soggybag/CVSpeak/hardware/README.md

# CVSpeak hardware

The Eurorack module: 14 HP, one PCB plus a front panel, with a Raspberry Pi Pico 2 and an ES8388 codec. The firmware lives in `../firmware/`, and the DSP core it shares with the VCV plugin lives in `../dsp/`.

## Docs

- [Hardware decisions](docs/Hardware%20Decisions.md): what was decided and why, the circuit blocks, open items, and what to bench on the Palimpsest boards first.
- [Pin map](docs/Pin%20map.md): Pico 2 GPIO, mux channels, and the signal conventions for the firmware.
- Panel layout: `../tools/make_panel.py` (`make panel`). It is the single source of the hole and part positions, shared with the VCV panel.

## Status

2026-11-07: decisions, pin map and **schematic v0.0** (draft, not yet benched). `make schematic` regenerates `CVSpeak.kicad_sch` from `scripts/build_sch.py` and runs ERC.

## Files

| File | What |
|---|---|
| `CVSpeak.kicad_sch` | Generated: edit `scripts/build_sch.py`, not the sheet |
| `CVSpeak.kicad_sym` | Generated by `scripts/make_symbols.py`: the SH1106 OLED and the Pico 2 |
| `CVSpeak.pretty/` | Project footprints (button; OLED still to draw) |
| `scripts/sch.py`, `sx.py`, `lib.py` | Schematic helpers, copied from Palimpsest |
