soggybag/CVSpeak/hardware/CVSpeak.kicad_sch

## KiCad design hardware/CVSpeak.kicad_sch (2026-11-08)

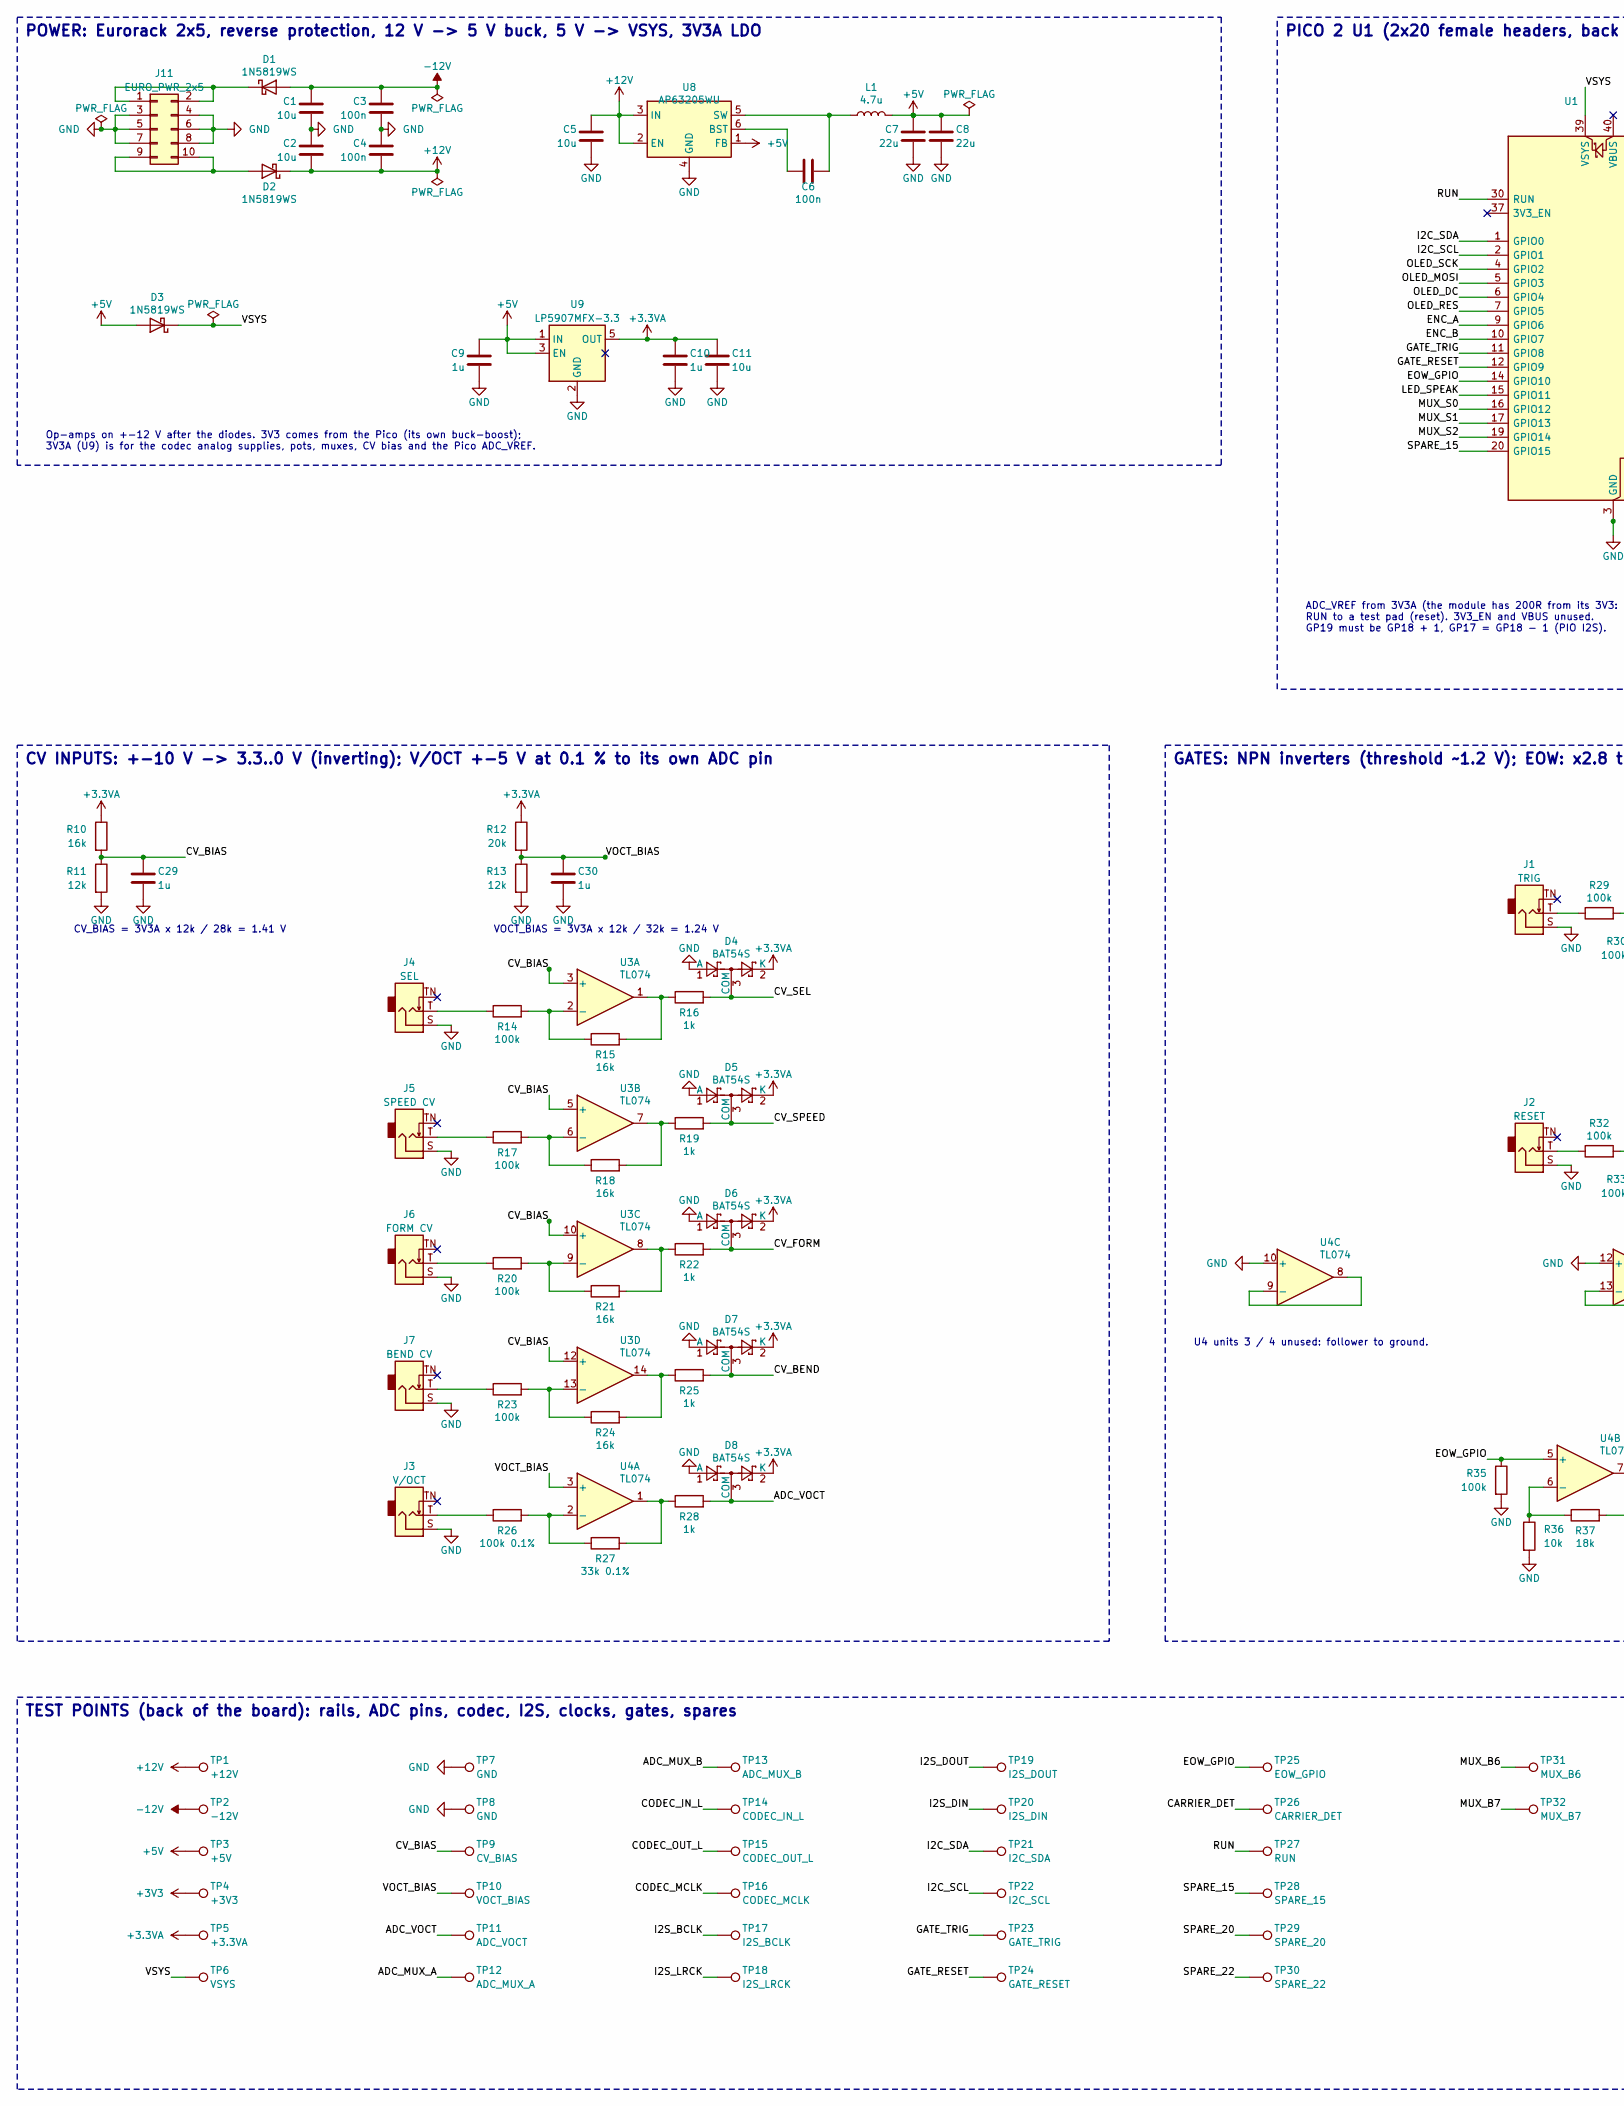
[picture p1: schematic CVSpeak.kicad_sch, part in row 1, column 1]

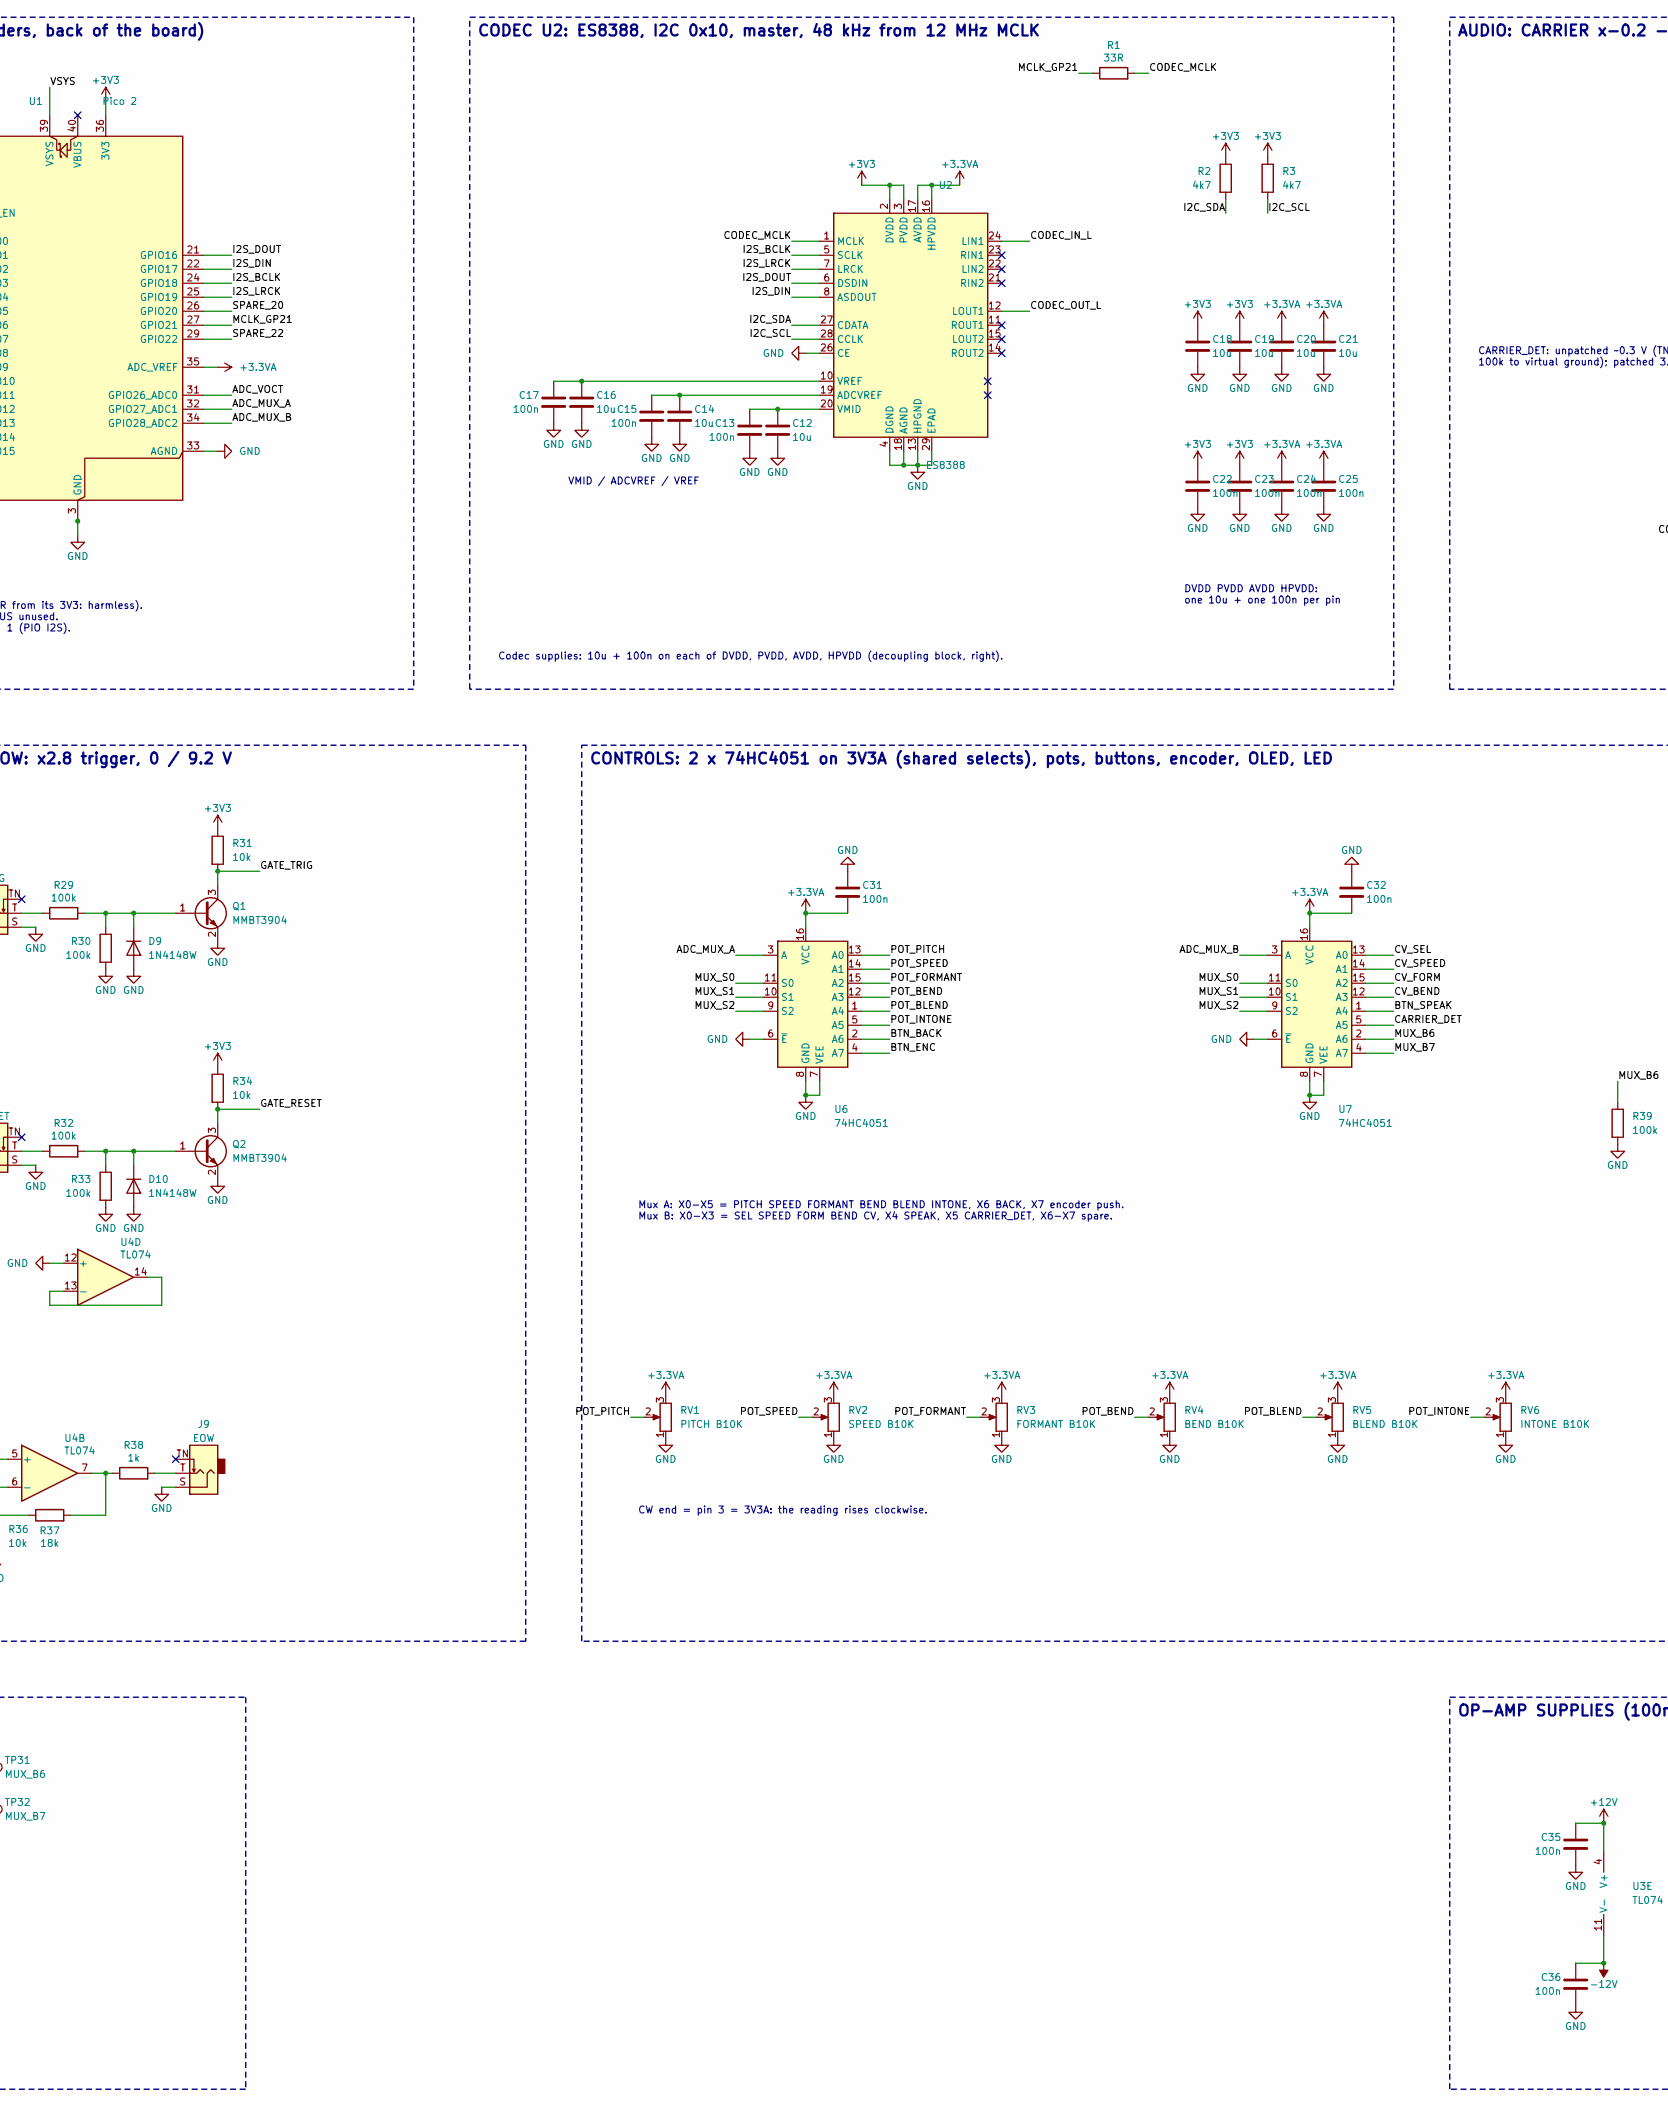
[picture p2: schematic CVSpeak.kicad_sch, part in row 1, column 2]

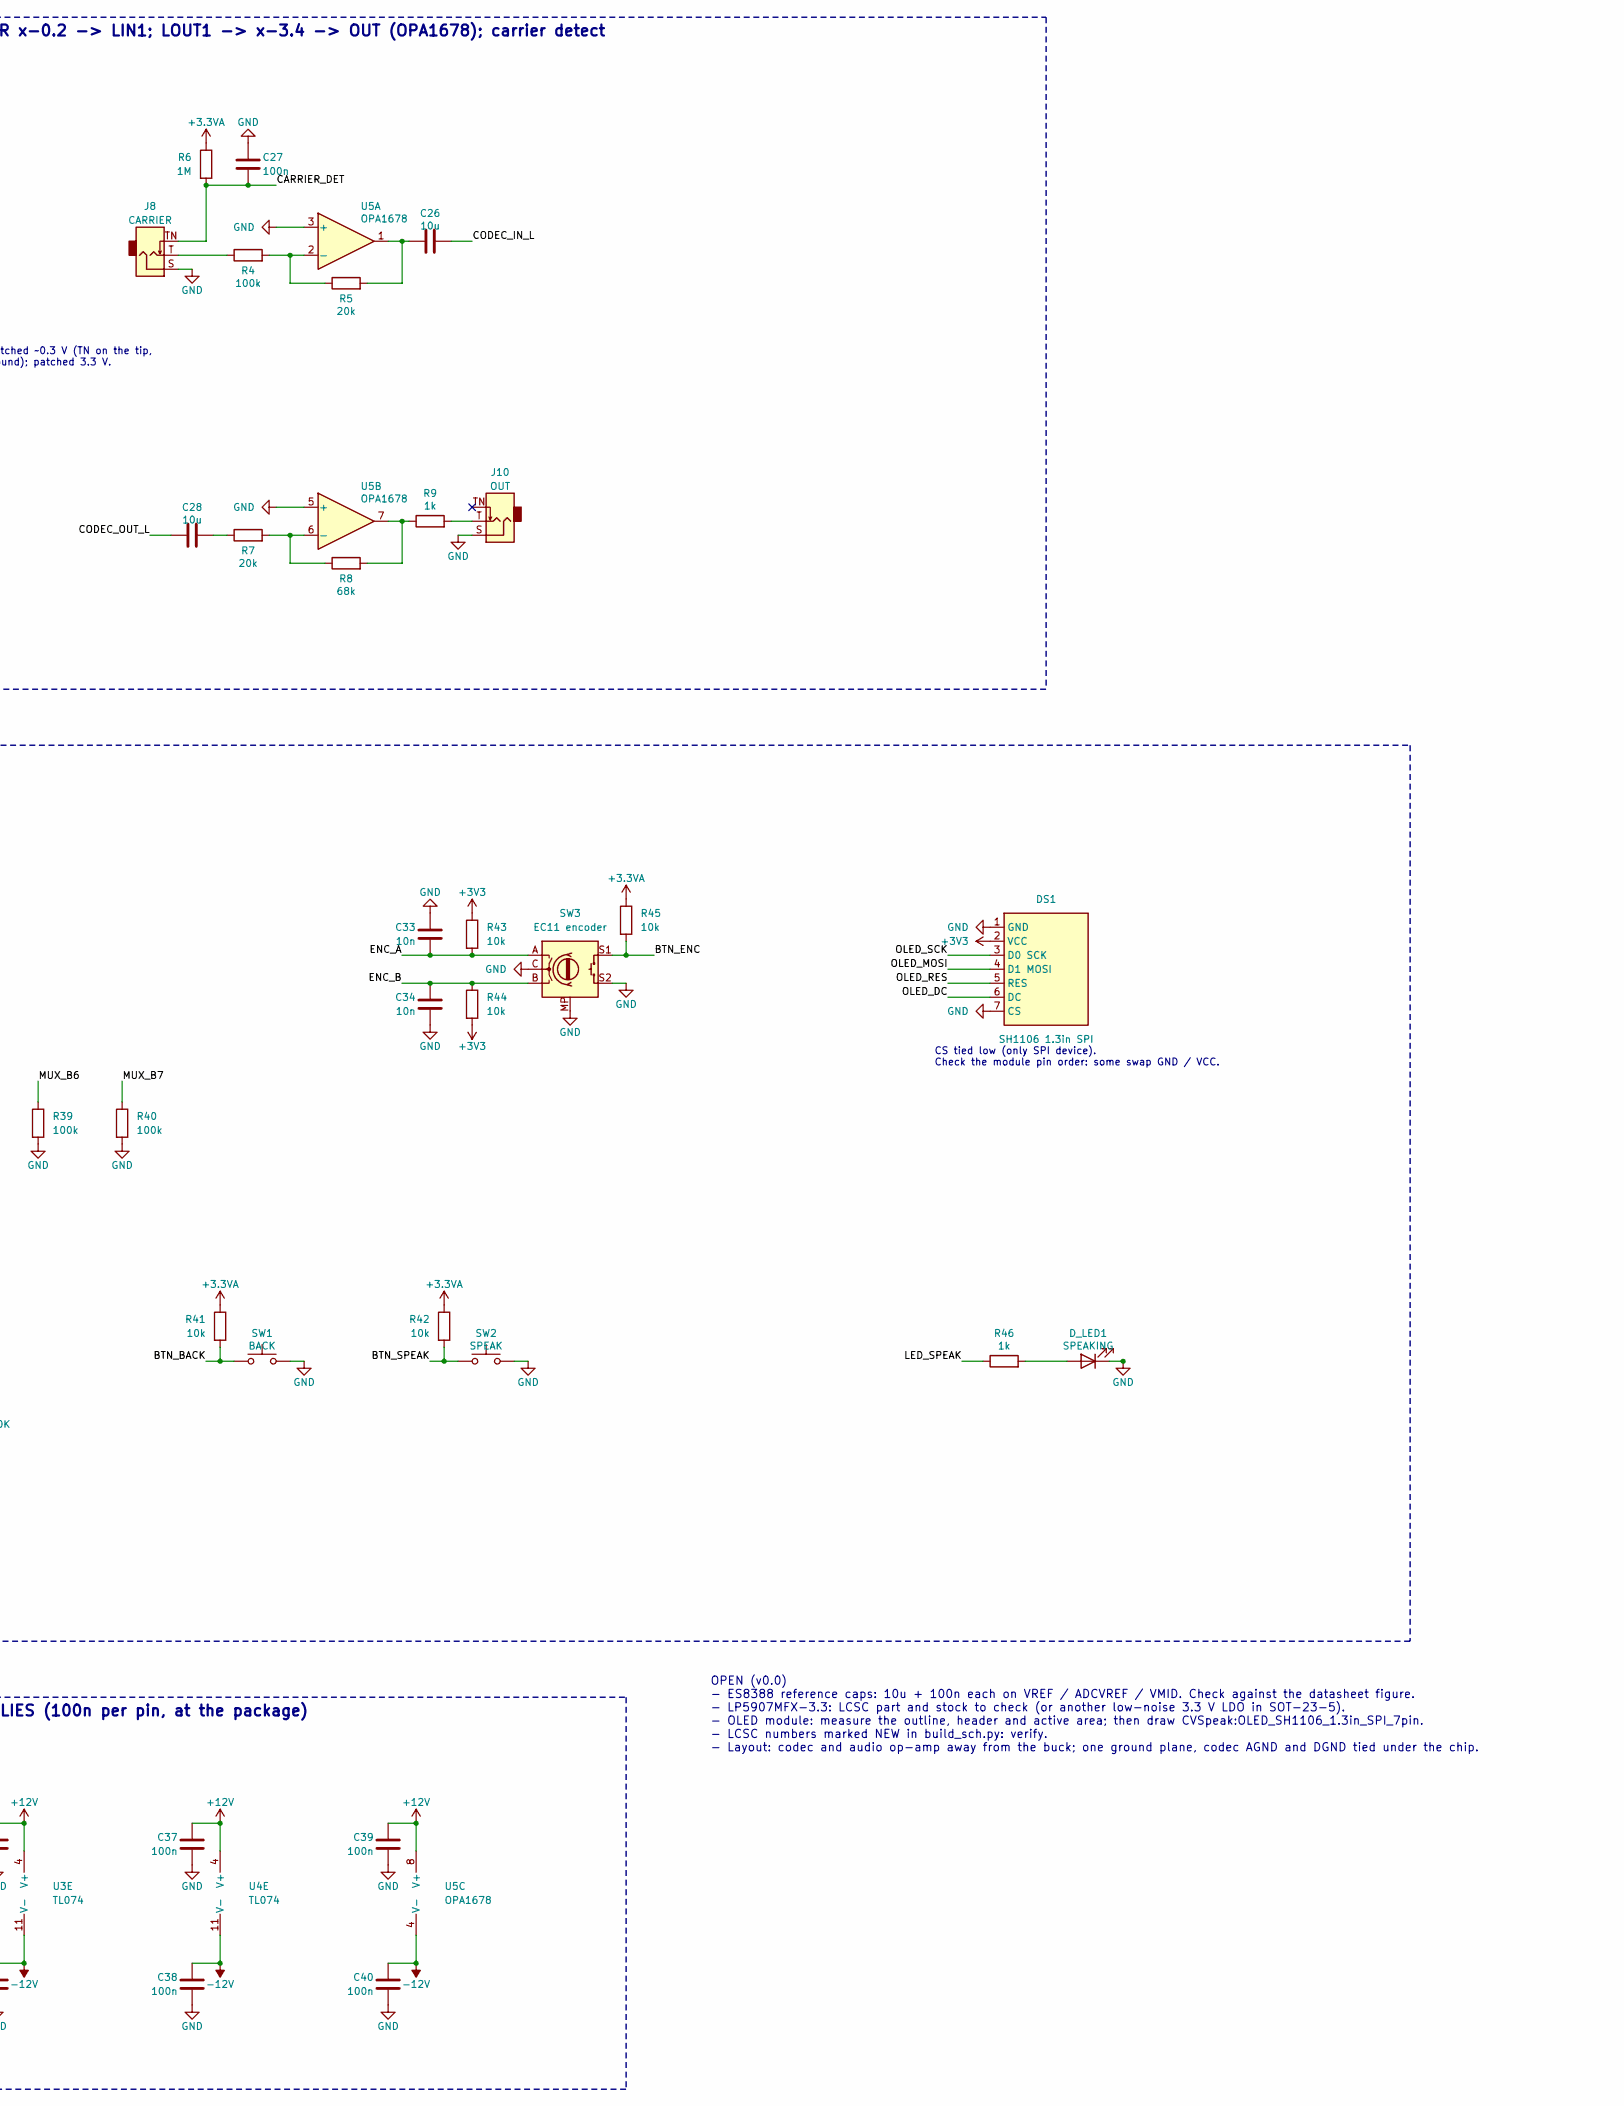
[picture p3: schematic CVSpeak.kicad_sch, part in row 1, column 3]

Parts:
C1, C2, C5, C11, C12, C14, C16, C18, C19, C20, C21, C26, C28: 10u; C_0805_2012Metric_Pad1.18x1.45mm_HandSolder; LCSC C15850
C3, C4, C6, C13, C15, C17, C22, C23, C24, C25, C27, C31, C32, C35, C36, C37, C38, C39, C40: 100n; C_0805_2012Metric_Pad1.18x1.45mm_HandSolder; LCSC C49678
C7, C8: 22u; C_0805_2012Metric_Pad1.18x1.45mm_HandSolder; LCSC C45783
C9, C10, C29, C30: 1u; C_0805_2012Metric_Pad1.18x1.45mm_HandSolder; LCSC C28323
C33, C34: 10n; C_0805_2012Metric_Pad1.18x1.45mm_HandSolder; LCSC C1710
D1, D2, D3: 1N5819WS; D_SOD-323; LCSC C191023
D4, D5, D6, D7, D8: BAT54S; SOT-23; LCSC C19726
D9, D10: 1N4148W; D_SOD-123; LCSC C81598
DS1: SH1106 1.3in SPI; OLED_SH1106_1.3in_SPI_7pin
D_LED1: SPEAKING; LED_D3.0mm
J1: TRIG; Jack_3.5mm_QingPu_WQP-PJ398SM_Vertical_CircularHoles
J2: RESET; Jack_3.5mm_QingPu_WQP-PJ398SM_Vertical_CircularHoles
J3: V/OCT; Jack_3.5mm_QingPu_WQP-PJ398SM_Vertical_CircularHoles
J4: SEL; Jack_3.5mm_QingPu_WQP-PJ398SM_Vertical_CircularHoles
J5: SPEED CV; Jack_3.5mm_QingPu_WQP-PJ398SM_Vertical_CircularHoles
J6: FORM CV; Jack_3.5mm_QingPu_WQP-PJ398SM_Vertical_CircularHoles
J7: BEND CV; Jack_3.5mm_QingPu_WQP-PJ398SM_Vertical_CircularHoles
J8: CARRIER; Jack_3.5mm_QingPu_WQP-PJ398SM_Vertical_CircularHoles
J9: EOW; Jack_3.5mm_QingPu_WQP-PJ398SM_Vertical_CircularHoles
J10: OUT; Jack_3.5mm_QingPu_WQP-PJ398SM_Vertical_CircularHoles
J11: EURO_PWR_2x5; IDC-Header_2x05_P2.54mm_Vertical
L1: 4.7u; L_Bourns-SRN4018; LCSC C780206
Q1, Q2: MMBT3904; SOT-23; LCSC C20526
R1: 33R; R_0805_2012Metric_Pad1.20x1.40mm_HandSolder; LCSC C17634
R2, R3: 4k7; R_0805_2012Metric_Pad1.20x1.40mm_HandSolder; LCSC C17673
R4, R14, R17, R20, R23, R29, R30, R32, R33, R35, R39, R40: 100k; R_0805_2012Metric_Pad1.20x1.40mm_HandSolder; LCSC C149504
R5, R7, R12: 20k; R_0805_2012Metric_Pad1.20x1.40mm_HandSolder; LCSC C4328
R6: 1M; R_0805_2012Metric_Pad1.20x1.40mm_HandSolder; LCSC C17514
R8: 68k; R_0805_2012Metric_Pad1.20x1.40mm_HandSolder; LCSC C17801
R9, R16, R19, R22, R25, R28, R38, R46: 1k; R_0805_2012Metric_Pad1.20x1.40mm_HandSolder; LCSC C17513
R10, R15, R18, R21, R24: 16k; R_0805_2012Metric_Pad1.20x1.40mm_HandSolder; LCSC C17490
R11, R13: 12k; R_0805_2012Metric_Pad1.20x1.40mm_HandSolder; LCSC C17444
R26: 100k 0.1%; R_0805_2012Metric_Pad1.20x1.40mm_HandSolder; LCSC C122537
R27: 33k 0.1%; R_0805_2012Metric_Pad1.20x1.40mm_HandSolder; LCSC C2849182
R31, R34, R36, R41, R42, R43, R44, R45: 10k; R_0805_2012Metric_Pad1.20x1.40mm_HandSolder; LCSC C17414
R37: 18k; R_0805_2012Metric_Pad1.20x1.40mm_HandSolder; LCSC C17506
RV1: PITCH B10K; Potentiometer_Alpha_RD901F-40-00D_Single_Vertical
RV2: SPEED B10K; Potentiometer_Alpha_RD901F-40-00D_Single_Vertical
RV3: FORMANT B10K; Potentiometer_Alpha_RD901F-40-00D_Single_Vertical
RV4: BEND B10K; Potentiometer_Alpha_RD901F-40-00D_Single_Vertical
RV5: BLEND B10K; Potentiometer_Alpha_RD901F-40-00D_Single_Vertical
RV6: INTONE B10K; Potentiometer_Alpha_RD901F-40-00D_Single_Vertical
SW1: BACK; SW_Push_Round_D12mm_P5.00mm_DAIER_TSL-A064
SW2: SPEAK; SW_Push_Round_D12mm_P5.00mm_DAIER_TSL-A064
SW3: EC11 encoder; RotaryEncoder_Alps_EC11E-Switch_Vertical_H20mm
TP1: +12V; TestPoint_Pad_D1.5mm
TP2: -12V; TestPoint_Pad_D1.5mm
TP3: +5V; TestPoint_Pad_D1.5mm
TP4: +3V3; TestPoint_Pad_D1.5mm
TP5: +3.3VA; TestPoint_Pad_D1.5mm
TP6: VSYS; TestPoint_Pad_D1.5mm
TP7, TP8: GND; TestPoint_THTPad_D2.0mm_Drill1.0mm
TP9: CV_BIAS; TestPoint_Pad_D1.5mm
TP10: VOCT_BIAS; TestPoint_Pad_D1.5mm
TP11: ADC_VOCT; TestPoint_Pad_D1.5mm
TP12: ADC_MUX_A; TestPoint_Pad_D1.5mm
TP13: ADC_MUX_B; TestPoint_Pad_D1.5mm
TP14: CODEC_IN_L; TestPoint_Pad_D1.5mm
TP15: CODEC_OUT_L; TestPoint_Pad_D1.5mm
TP16: CODEC_MCLK; TestPoint_Pad_D1.5mm
TP17: I2S_BCLK; TestPoint_Pad_D1.5mm
TP18: I2S_LRCK; TestPoint_Pad_D1.5mm
TP19: I2S_DOUT; TestPoint_Pad_D1.5mm
TP20: I2S_DIN; TestPoint_Pad_D1.5mm
TP21: I2C_SDA; TestPoint_Pad_D1.5mm
TP22: I2C_SCL; TestPoint_Pad_D1.5mm
TP23: GATE_TRIG; TestPoint_Pad_D1.5mm
TP24: GATE_RESET; TestPoint_Pad_D1.5mm
TP25: EOW_GPIO; TestPoint_Pad_D1.5mm
TP26: CARRIER_DET; TestPoint_Pad_D1.5mm
TP27: RUN; TestPoint_Pad_D1.5mm
TP28: SPARE_15; TestPoint_Pad_D1.5mm
TP29: SPARE_20; TestPoint_Pad_D1.5mm
TP30: SPARE_22; TestPoint_Pad_D1.5mm
TP31: MUX_B6; TestPoint_Pad_D1.5mm
TP32: MUX_B7; TestPoint_Pad_D1.5mm
U1: Pico 2; RaspberryPi_Pico_Common_THT
U2: ES8388; QFN-28-1EP_4x4mm_P0.45mm_EP2.6x2.6mm; LCSC C365736
U3, U4: TL074; SOIC-14_3.9x8.7mm_P1.27mm; LCSC C6963
U5: OPA1678; SOIC-8_3.9x4.9mm_P1.27mm; LCSC C192421
U6, U7: 74HC4051; SOIC-16_3.9x9.9mm_P1.27mm; LCSC C132065
U8: AP63205WU; TSOT-23-6; LCSC C2071056
U9: LP5907MFX-3.3; SOT-23-5

Connections:
+3.3VA: C10.1, C11.1, C20.1, C21.1, C24.1, C25.1, C31.2, C32.2, D4.2 (K), D5.2 (K), D6.2 (K), D7.2 (K), D8.2 (K), R6.1, R10.1, R12.1, R41.1, R42.1, R45.1, RV1.3, RV2.3, RV3.3, RV4.3, RV5.3, RV6.3, TP5.1, U1.35 (ADC_VREF), U2.16 (HPVDD), U2.17 (AVDD), U6.16 (VCC), U7.16 (VCC), U9.5 (OUT)
+3V3: C18.1, C19.1, C22.1, C23.1, DS1.2 (VCC), R2.1, R3.1, R31.1, R34.1, R43.1, R44.2, TP4.1, U1.36 (3V3), U2.2 (DVDD), U2.3 (PVDD)
+12V: C1.1, C1.2, C2.1, C2.2, C3.1, C3.2, C4.1, C4.2, C5.1, C5.2, C7.1, C7.2, C8.1, C8.2, C9.1, C9.2, C10.2, C11.2, C12.2, C13.2, C14.2, C15.2, C16.2, C17.2, C18.2, C19.2, C20.2, C21.2, C22.2, C23.2, C24.2, C25.2, C27.1, C29.2, C30.2, C31.1, C32.1, C33.1, C34.2, C35.1, C35.2, C36.1, C36.2, C37.1, C37.2, C38.1, C38.2, C39.1, C39.2, C40.1, C40.2, D1.2 (A), D2.1 (K), D3.1 (K), D3.2 (A), D4.1 (A), D5.1 (A), D6.1 (A), D7.1 (A), D8.1 (A), D9.2 (A), D10.2 (A), DS1.1 (GND), DS1.7 (CS), D_LED1.1 (K), J1.S, J2.S, J3.S, J4.S, J5.S, J6.S, J7.S, J8.S, J9.S, J10.S, J11.3, J11.4, J11.5, J11.6, J11.7, J11.8, L1.2, Q1.2 (E), Q2.2 (E), R11.2, R13.2, R30.2, R33.2, R35.2, R36.2, R39.2, R40.2, RV1.1, RV2.1, RV3.1, RV4.1, RV5.1, RV6.1, SW1.2, SW2.2, SW3.C, SW3.MP, SW3.S2, TP1.1, TP2.1, TP3.1, TP6.1, TP7.1, TP8.1, U1.3 (GND), U1.8 (GND), U1.13 (GND), U1.18 (GND), U1.23 (GND), U1.28 (GND), U1.33 (AGND), U1.38 (GND), U1.39 (VSYS), U2.4 (DGND), U2.13 (HPGND), U2.18 (AGND), U2.26 (CE), U2.29 (EPAD), U3.4 (V+), U3.11 (V-), U4.4 (V+), U4.10 (+), U4.11 (V-), U4.12 (+), U5.3 (+), U5.4 (V-), U5.5 (+), U5.8 (V+), U6.6 (~E), U6.7 (VEE), U6.8 (GND), U7.6 (~E), U7.7 (VEE), U7.8 (GND), U8.1 (FB), U8.2 (EN), U8.3 (IN), U8.4 (GND), U9.1 (IN), U9.2 (GND), U9.3 (EN)
ADC_MUX_A: TP12.1, U1.32 (GPIO27_ADC1), U6.3 (A)
ADC_MUX_B: TP13.1, U1.34 (GPIO28_ADC2), U7.3 (A)
ADC_VOCT: D8.3 (COM), R28.2, TP11.1, U1.31 (GPIO26_ADC0)
BTN_BACK: R41.2, SW1.1, U6.2 (A6)
BTN_ENC: R45.2, SW3.S1, U6.4 (A7)
BTN_SPEAK: R42.2, SW2.1, U7.1 (A4)
CARRIER_DET: C27.2, J8.TN, R6.2, TP26.1, U7.5 (A5)
CODEC_IN_L: C26.2, TP14.1, U2.24 (LIN1)
CODEC_MCLK: R1.2, TP16.1, U2.1 (MCLK)
CODEC_OUT_L: C28.1, TP15.1, U2.12 (LOUT1)
CV_BEND: D7.3 (COM), R25.2, U7.12 (A3)
CV_BIAS: C29.1, R10.2, R11.1, TP9.1, U3.3 (+), U3.5 (+), U3.10 (+), U3.12 (+)
CV_FORM: D6.3 (COM), R22.2, U7.15 (A2)
CV_SEL: D4.3 (COM), R16.2, U7.13 (A0)
CV_SPEED: D5.3 (COM), R19.2, U7.14 (A1)
ENC_A: C33.2, R43.2, SW3.A, U1.9 (GPIO6)
ENC_B: C34.1, R44.1, SW3.B, U1.10 (GPIO7)
EOW_GPIO: R35.1, TP25.1, U1.14 (GPIO10), U4.5 (+)
GATE_RESET: Q2.3 (C), R34.2, TP24.1, U1.12 (GPIO9)
GATE_TRIG: Q1.3 (C), R31.2, TP23.1, U1.11 (GPIO8)
I2C_SCL: R3.2, TP22.1, U1.2 (GPIO1), U2.28 (CCLK)
I2C_SDA: R2.2, TP21.1, U1.1 (GPIO0), U2.27 (CDATA)
I2S_BCLK: TP17.1, U1.24 (GPIO18), U2.5 (SCLK)
I2S_DIN: TP20.1, U1.22 (GPIO17), U2.8 (ASDOUT)
I2S_DOUT: TP19.1, U1.21 (GPIO16), U2.6 (DSDIN)
I2S_LRCK: TP18.1, U1.25 (GPIO19), U2.7 (LRCK)
LED_SPEAK: R46.1, U1.15 (GPIO11)
MCLK_GP21: R1.1, U1.27 (GPIO21)
MUX_B6: R39.1, TP31.1, U7.2 (A6)
MUX_B7: R40.1, TP32.1, U7.4 (A7)
MUX_S0: U1.16 (GPIO12), U6.11 (S0), U7.11 (S0)
MUX_S1: U1.17 (GPIO13), U6.10 (S1), U7.10 (S1)
MUX_S2: U1.19 (GPIO14), U6.9 (S2), U7.9 (S2)
unnamed: C6.1, U8.6 (BST)
unnamed: C6.2, L1.1, U8.5 (SW)
unnamed: C12.1, C13.1, U2.20 (VMID)
unnamed: C14.1, C15.1, U2.19 (ADCVREF)
unnamed: C16.1, C17.1, U2.10 (VREF)
unnamed: C26.1, R5.2, U5.1
unnamed: C28.2, R7.1
unnamed: D1.1 (K), J11.1, J11.2
unnamed: D2.2 (A), J11.9, J11.10
unnamed: D9.1 (K), Q1.1 (B), R29.2, R30.1
unnamed: D10.1 (K), Q2.1 (B), R32.2, R33.1
unnamed: D_LED1.2 (A), R46.2
unnamed: J1.T, R29.1
unnamed: J2.T, R32.1
unnamed: J3.T, R26.1
unnamed: J4.T, R14.1
unnamed: J5.T, R17.1
unnamed: J6.T, R20.1
unnamed: J7.T, R23.1
unnamed: J8.T, R4.1
unnamed: J9.T, R38.2
unnamed: J10.T, R9.2
unnamed: R4.2, R5.1, U5.2 (-)
unnamed: R7.2, R8.1, U5.6 (-)
unnamed: R8.2, R9.1, U5.7
unnamed: R14.2, R15.1, U3.2 (-)
unnamed: R15.2, R16.1, U3.1
unnamed: R17.2, R18.1, U3.6 (-)
unnamed: R18.2, R19.1, U3.7
unnamed: R20.2, R21.1, U3.9 (-)
unnamed: R21.2, R22.1, U3.8
unnamed: R23.2, R24.1, U3.13 (-)
unnamed: R24.2, R25.1, U3.14
unnamed: R26.2, R27.1, U4.2 (-)
unnamed: R27.2, R28.1, U4.1
unnamed: R36.1, R37.1, U4.6 (-)
unnamed: R37.2, R38.1, U4.7
unnamed: U4.8, U4.9 (-)
unnamed: U4.13 (-), U4.14
OLED_DC: DS1.6 (DC), U1.6 (GPIO4)
OLED_MOSI: DS1.4 (D1 MOSI), U1.5 (GPIO3)
OLED_RES: DS1.5 (RES), U1.7 (GPIO5)
OLED_SCK: DS1.3 (D0 SCK), U1.4 (GPIO2)
POT_BEND: RV4.2, U6.12 (A3)
POT_BLEND: RV5.2, U6.1 (A4)
POT_FORMANT: RV3.2, U6.15 (A2)
POT_INTONE: RV6.2, U6.5 (A5)
POT_PITCH: RV1.2, U6.13 (A0)
POT_SPEED: RV2.2, U6.14 (A1)
RUN: TP27.1, U1.30 (RUN)
SPARE_15: TP28.1, U1.20 (GPIO15)
SPARE_20: TP29.1, U1.26 (GPIO20)
SPARE_22: TP30.1, U1.29 (GPIO22)
VOCT_BIAS: C30.1, R12.2, R13.1, TP10.1, U4.3 (+)

Notes on the sheet:
POWER: Eurorack 2x5, reverse protection, 12 V -> 5 V buck, 5 V -> VSYS, 3V3A LDO
Op-amps on +-12 V after the diodes. 3V3 comes from the Pico (its own buck-boost); 3V3A (U9) is for the codec analog supplies, pots, muxes, CV bias and the Pico ADC_VREF.
PICO 2 U1 (2x20 female headers, back of the board)
ADC_VREF from 3V3A (the module has 200R from its 3V3: harmless). RUN to a test pad (reset). 3V3_EN and VBUS unused. GP19 must be GP18 + 1, GP17 = GP18 - 1 (PIO I2S).
CODEC U2: ES8388, I2C 0x10, master, 48 kHz from 12 MHz MCLK
VMID / ADCVREF / VREF
Codec supplies: 10u + 100n on each of DVDD, PVDD, AVDD, HPVDD (decoupling block, right).
DVDD PVDD AVDD HPVDD: one 10u + one 100n per pin
AUDIO: CARRIER x-0.2 -> LIN1; LOUT1 -> x-3.4 -> OUT (OPA1678); carrier detect
CARRIER_DET: unpatched ~0.3 V (TN on the tip, 100k to virtual ground); patched 3.3 V.
CV INPUTS: +-10 V -> 3.3..0 V (inverting); V/OCT +-5 V at 0.1 % to its own ADC pin
CV_BIAS = 3V3A x 12k / 28k = 1.41 V
VOCT_BIAS = 3V3A x 12k / 32k = 1.24 V
GATES: NPN inverters (threshold ~1.2 V); EOW: x2.8 trigger, 0 / 9.2 V
U4 units 3 / 4 unused: follower to ground.
CONTROLS: 2 x 74HC4051 on 3V3A (shared selects), pots, buttons, encoder, OLED, LED
Mux A: X0-X5 = PITCH SPEED FORMANT BEND BLEND INTONE, X6 BACK, X7 encoder push. Mux B: X0-X3 = SEL SPEED FORM BEND CV, X4 SPEAK, X5 CARRIER_DET, X6-X7 spare.
CW end = pin 3 = 3V3A: the reading rises clockwise.
CS tied low (only SPI device). Check the module pin order: some swap GND / VCC.
OP-AMP SUPPLIES (100n per pin, at the package)
TEST POINTS (back of the board): rails, ADC pins, codec, I2S, clocks, gates, spares
OPEN (v0.0) - ES8388 reference caps: 10u + 100n each on VREF / ADCVREF / VMID. Check against the datasheet figure. - LP5907MFX-3.3: LCSC part and stock to check (or another low-noise 3.3 V LDO in SOT-23-5). - OLED module: measure the outline, header and active area; then draw CVSpeak:OLED_SH1106_1.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
