soggybag/CVSpeak/dsp/src/framebuffer.cpp

#include "cvspeak/framebuffer.h"

namespace cvspeak {

namespace {

// Glyphs are drawn as text so they are easy to edit: '#' is a lit pixel.
constexpr uint8_t row(const char* s) {
    uint8_t v = 0;
    for (int i = 0; i < 5; ++i) v = static_cast<uint8_t>((v << 1) | (s[i] == '#' ? 1 : 0));
    return v;
}

struct Glyph {
    char c;
    uint8_t rows[7];
};

#define G(c, a, b, d, e, f, g, h) {c, {row(a), row(b), row(d), row(e), row(f), row(g), row(h)}}

constexpr Glyph kGlyphs[] = {
    G(' ', ".....", ".....", ".....", ".....", ".....", ".....", "....."),
    G('A', ".###.", "#...#", "#...#", "#####", "#...#", "#...#", "#...#"),
    G('B', "####.", "#...#", "#...#", "####.", "#...#", "#...#", "####."),
    G('C', ".###.", "#...#", "#....", "#....", "#....", "#...#", ".###."),
    G('D', "####.", "#...#", "#...#", "#...#", "#...#", "#...#", "####."),
    G('E', "#####", "#....", "#....", "####.", "#....", "#....", "#####"),
    G('F', "#####", "#....", "#....", "####.", "#....", "#....", "#...."),
    G('G', ".###.", "#...#", "#....", "#.###", "#...#", "#...#", ".####"),
    G('H', "#...#", "#...#", "#...#", "#####", "#...#", "#...#", "#...#"),
    G('I', ".###.", "..#..", "..#..", "..#..", "..#..", "..#..", ".###."),
    G('J', "..###", "...#.", "...#.", "...#.", "...#.", "#..#.", ".##.."),
    G('K', "#...#", "#..#.", "#.#..", "##...", "#.#..", "#..#.", "#...#"),
    G('L', "#....", "#....", "#....", "#....", "#....", "#....", "#####"),
    G('M', "#...#", "##.##", "#.#.#", "#.#.#", "#...#", "#...#", "#...#"),
    G('N', "#...#", "#...#", "##..#", "#.#.#", "#..##", "#...#", "#...#"),
    G('O', ".###.", "#...#", "#...#", "#...#", "#...#", "#...#", ".###."),
    G('P', "####.", "#...#", "#...#", "####.", "#....", "#....", "#...."),
    G('Q', ".###.", "#...#", "#...#", "#...#", "#.#.#", "#..#.", ".##.#"),
    G('R', "####.", "#...#", "#...#", "####.", "#.#..", "#..#.", "#...#"),
    G('S', ".###.", "#...#", "#....", ".###.", "....#", "#...#", ".###."),
    G('T', "#####", "..#..", "..#..", "..#..", "..#..", "..#..", "..#.."),
    G('U', "#...#", "#...#", "#...#", "#...#", "#...#", "#...#", ".###."),
    G('V', "#...#", "#...#", "#...#", "#...#", "#...#", ".#.#.", "..#.."),
    G('W', "#...#", "#...#", "#...#", "#.#.#", "#.#.#", "#.#.#", ".#.#."),
    G('X', "#...#", "#...#", ".#.#.", "..#..", ".#.#.", "#...#", "#...#"),
    G('Y', "#...#", "#...#", ".#.#.", "..#..", "..#..", "..#..", "..#.."),
    G('Z', "#####", "....#", "...#.", "..#..", ".#...", "#....", "#####"),
    G('0', ".###.", "#...#", "#..##", "#.#.#", "##..#", "#...#", ".###."),
    G('1', "..#..", ".##..", "..#..", "..#..", "..#..", "..#..", ".###."),
    G('2', ".###.", "#...#", "....#", "...#.", "..#..", ".#...", "#####"),
    G('3', "#####", "...#.", "..#..", "...#.", "....#", "#...#", ".###."),
    G('4', "...#.", "..##.", ".#.#.", "#..#.", "#####", "...#.", "...#."),
    G('5', "#####", "#....", "####.", "....#", "....#", "#...#", ".###."),
    G('6', "..##.", ".#...", "#....", "####.", "#...#", "#...#", ".###."),
    G('7', "#####", "....#", "...#.", "..#..", ".#...", ".#...", ".#..."),
    G('8', ".###.", "#...#", "#...#", ".###.", "#...#", "#...#", ".###."),
    G('9', ".###.", "#...#", "#...#", ".####", "....#", "...#.", ".##.."),
    G('.', ".....", ".....", ".....", ".....", ".....", ".##..", ".##.."),
    G(',', ".....", ".....", ".....", ".....", ".##..", "..#..", ".#..."),
    G(';', ".....", ".##..", ".##..", ".....", ".##..", "..#..", ".#..."),
    G(':', ".....", ".##..", ".##..", ".....", ".##..", ".##..", "....."),
    G('\'', "..#..", "..#..", ".#...", ".....", ".....", ".....", "....."),
    G('"', ".#.#.", ".#.#.", ".#.#.", ".....", ".....", ".....", "....."),
    G('!', "..#..", "..#..", "..#..", "..#..", "..#..", ".....", "..#.."),
    G('?', ".###.", "#...#", "....#", "...#.", "..#..", ".....", "..#.."),
    G('-', ".....", ".....", ".....", "#####", ".....", ".....", "....."),
    G('+', ".....", "..#..", "..#..", "#####", "..#..", "..#..", "....."),
    G('=', ".....", ".....", "#####", ".....", "#####", ".....", "....."),
    G('_', ".....", ".....", ".....", ".....", ".....", ".....", "#####"),
    G('/', "....#", "....#", "...#.", "..#..", ".#...", "#....", "#...."),
    G('%', "##...", "##..#", "...#.", "..#..", ".#...", "#..##", "...##"),
    G('<', "...#.", "..#..", ".#...", "#....", ".#...", "..#..", "...#."),
    G('>', ".#...", "..#..", "...#.", "....#", "...#.", "..#..", ".#..."),
    G('(', "...#.", "..#..", ".#...", ".#...", ".#...", "..#..", "...#."),
    G(')', ".#...", "..#..", "...#.", "...#.", "...#.", "..#..", ".#..."),
    G('[', ".###.", ".#...", ".#...", ".#...", ".#...", ".#...", ".###."),
    G(']', ".###.", "...#.", "...#.", "...#.", "...#.", "...#.", ".###."),
    G('*', ".....", "..#..", "#.#.#", ".###.", "#.#.#", "..#..", "....."),
    G('#', ".#.#.", ".#.#.", "#####", ".#.#.", "#####", ".#.#.", ".#.#."),
    G('&', ".##..", "#..#.", "#.#..", ".#...", "#.#.#", "#..#.", ".##.#"),
};

#undef G

constexpr int kNumGlyphs = static_cast<int>(sizeof(kGlyphs) / sizeof(kGlyphs[0]));

// ASCII 32..127 -> glyph index, built at compile time. Missing characters
// (and the '?' fallback) show as a box.
struct GlyphIndex {
    int8_t index[96];
    constexpr GlyphIndex() : index{} {
        for (int i = 0; i < 96; ++i) index[i] = -1;
        for (int g = 0; g < kNumGlyphs; ++g) index[kGlyphs[g].c - 32] = static_cast<int8_t>(g);
    }
};

constexpr GlyphIndex kIndex{};
constexpr uint8_t kBox[7] = {0x1f, 0x11, 0x11, 0x11, 0x11, 0x11, 0x1f};

const uint8_t* glyphRows(char c) {
    if (c >= 'a' && c <= 'z') c = static_cast<char>(c - 'a' + 'A');
    const int i = static_cast<unsigned char>(c) - 32;
    if (i < 0 || i >= 96 || kIndex.index[i] < 0) return kBox;
    return kGlyphs[kIndex.index[i]].rows;
}

}  // namespace

void Framebuffer::clear() {
    for (auto& b : data_) b = 0;
}

void Framebuffer::setPixel(int x, int y, bool on) {
    if (x < 0 || x >= kWidth || y < 0 || y >= kHeight) return;
    uint8_t& b = data_[(y / 8) * kWidth + x];
    const uint8_t bit = static_cast<uint8_t>(1u << (y % 8));
    b = on ? static_cast<uint8_t>(b | bit) : static_cast<uint8_t>(b & ~bit);
}

bool Framebuffer::pixel(int x, int y) const {
    if (x < 0 || x >= kWidth || y < 0 || y >= kHeight) return false;
    return (data_[(y / 8) * kWidth + x] >> (y % 8)) & 1u;
}

void Framebuffer::fillRect(int x, int y, int w, int h, bool on) {
    for (int j = y; j < y + h; ++j)
        for (int i = x; i < x + w; ++i) setPixel(i, j, on);
}

void Framebuffer::drawGlyph(int x, int y, char c, int scale, bool on) {
    const uint8_t* rows = glyphRows(c);
    for (int r = 0; r < kGlyphHeight; ++r) {
        for (int col = 0; col < kGlyphWidth; ++col) {
            if (rows[r] & (0x10 >> col)) fillRect(x + col * scale, y + r * scale, scale, scale, on);
        }
    }
}

int Framebuffer::drawText(int x, int y, const char* text, int scale, bool on) {
    int cx = x;
    for (const char* p = text; *p; ++p) {
        drawGlyph(cx, y, *p, scale, on);
        cx += kAdvance * scale;
    }
    return textWidth(text, scale);
}

int Framebuffer::textWidth(const char* text, int scale) {
    int n = 0;
    for (const char* p = text; *p; ++p) ++n;
    if (n == 0) return 0;
    return (n * kAdvance - (kAdvance - kGlyphWidth)) * scale;  // no gap after the last glyph
}

}  // namespace cvspeak
