soggybag/CVSpeak/dsp/include/cvspeak/lpc_analysis.h

#pragma once
// LPC analysis: autocorrelation, Levinson-Durbin and pitch detection.
// Used offline by tools/lpc_encode, and later for the real-time LPC vocoder.
//
// Sign convention: A(z) = 1 + sum(a_i z^-i). The reflection coefficients
// returned by levinson() drive LatticeFilter (lpc_synth.h) directly.

namespace cvspeak::lpc {

constexpr int kMaxAnalysisOrder = 16;

// r[0..order] = autocorrelation of x[0..n).
void autocorrelate(const float* x, int n, float* r, int order);

// Levinson-Durbin recursion. Writes k[0..order) and returns the final
// prediction error energy (in the units of r[0]).
float levinson(const float* r, int order, float* k);

// Normalized autocorrelation pitch detector. Returns the period in samples
// (fractional, parabolic interpolation) or 0 when the best correlation is
// below `threshold`. Prefers the shortest lag that correlates nearly as well
// as the best one, which avoids octave-down errors. `corrOut` may be null.
float detectPitch(const float* x, int n, int minLag, int maxLag, float threshold, float* corrOut);

// Per-frame cues for the voiced/unvoiced decision.
struct VoicingFeatures {
    float corr = 0.f;          // normalized pitch correlation (detectPitch corrOut)
    float k1 = 0.f;            // first reflection coefficient (< 0: low-frequency, vowel-like)
    float zcr = 0.f;           // zero crossings per sample of the raw signal
    int belowPeak = 0;         // energy codes below the loudest frame of the word
};

// Voiced (buzz) or unvoiced (noise)? Calling a vowel unvoiced plays a loud
// noise burst, so besides clear periodicity this accepts:
//   * vowel-like spectrum (K1 < -0.4) with weak periodicity, and
//   * frames near the word's peak loudness with moderate periodicity and a
//     low crossing rate. Pitch glides drop correlation to ~0.35-0.5; real
//     fricatives and plosive bursts are quieter, noisier, or less periodic.
bool classifyVoiced(const VoicingFeatures& f);

}  // namespace cvspeak::lpc
