soggybag/CVSpeak/(commit log)

2026-11-08 Phase 0: project skeleton, shared DSP core, desktop harness, VCV plugin
    - dsp/: shared C++17 core with stable Voice interface (placeholder buzz)
    - tests/ + tools/: unit tests and render-to-WAV harness (make test/render)
    - vcv/: Rack 2 plugin wrapper with Trig/Reset/V-Oct/Audio/EOW and OLED stand-in
    - PLAN.md: features, architecture, JLCPCB constraints, roadmap
    [CVSpeak.cpp, dsp_core.cpp, voice.cpp, voice.h]
2026-11-08 Add SPEAK button to kick-start EOW -> TRIG self-patching
    EOW only fires when a word ends, so a self-patched loop never starts on
    its own. The button ORs with the TRIG jack. Adds a test simulating the
    loop with Rack's one-sample cable delay.
2026-11-08 Phase 1: LPC speech engine, encoder and 30-word bank
    - lpc_format: TMS5220-style variable-length bitstream with CVSpeak's own
    quantization tables (arcsine-spaced K, log energy and pitch)
    - lpc_analysis: autocorrelation, Levinson-Durbin, pitch detection
    - LpcSynth: 8 kHz decoder with per-sample interpolation, 10-pole lattice,
    impulse/chirp excitation blend, de-emphasis, DC blocker
    - Voice: resamples to host rate; Pitch, Speed, Intonation, Chirp, Word
    - tools/lpc_encode + make_words.sh: `make words` encodes tools/words.txt
    spoken by macOS `say` into dsp/src/words_generated.cpp
    - VCV: Word/Speed/Intonation/Chirp knobs, word display, temporary labels
    - 12 unit tests; make vcv-link for fast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
2026-11-08 Phase 2: Word/Phrase modes, phrase sequencer, selection CV
    - sequencer: TRIG advances and wraps, RESET rewinds without cutting the
    current word (applied before TRIG), phrase change starts from the top
    - selectIndex: knob + CV at one item per semitone, wrapping
    - tools/phrases.txt -> make phrases -> dsp/src/phrases_generated.cpp,
    rejecting words missing from words.txt
    - VCV: Mode switch, Select knob with name tooltip, SEL CV jack, phrase
    display with spoken/next word highlighting
    - 19 unit tests
    [CVSpeak.cpp, dsp_core.cpp, sequencer.cpp, sequencer.h, voice.cpp]
2026-11-08 Fix noise bursts on fast pitch glides
    Fast pitch glides (e.g. the falling "are") dropped the pitch correlation
    below the voicing threshold, so loud vowel frames were encoded as
    unvoiced and played as vowel-shaped noise. A frame is now also voiced if
    its spectrum is vowel-like (K1 < -0.4) with weak periodicity (corr > 0.2).
    Fixes 22 frames across are/five/I/hello/the/control/again; real
    fricatives keep K1 > -0.2 and stay unvoiced. Adds a regression test.
2026-11-08 Phrase-driven vocabulary, better voicing, README
    - make words now takes its vocabulary from words.txt plus any new words
    used in phrases.txt; punctuation in phrases is ignored
    - words.txt supports pronunciation overrides: `word = how to say it`
    - tools/recordings/<word>.wav replaces `say` for that word (afconvert)
    - classifyVoiced(): frames near the word's peak loudness with moderate
    periodicity and a low zero-crossing rate are voiced, fixing noise
    bursts in AT, NYARLATHOTEP, AM, AND, INDEED; consonant bursts stay noise
    - Octave-error correction against neighbouring pitch periods
    - New phrases (51 words); README documents the word/phrase workflow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
    [lpc_analysis.cpp, lpc_analysis.h]
2026-11-08 Phase 3a+3b: Formant, Bend, Carrier, soft clip, shared display and menu
    3a: Formant shift (synth rate 8 kHz x 2^formant), Bend (bit flips and
    frame stutters), Carrier In with Blend, CV for Speed/Formant/Bend, and an
    output stage of a safety limiter plus tanh soft clip.
    3b: shared 128x64 framebuffer (SSD1306 page order) with a 5x7 font, and
    the screens and menu driven by encoder turn/push and Back. Intonation,
    Chirp and Mode move into the menu. SEL CV gets hysteresis. VCV gets an
    endless encoder widget, settings saved by name in the patch, migration
    of v2.0.x patches, and a hardware-size display option. make screens
    prints the screens as ASCII art.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
    [CVSpeak.cpp, dsp_core.cpp, framebuffer.cpp, framebuffer.h, lpc_format.h, lpc_synth.cpp, lpc_synth.h, sequencer.cpp]
2026-11-08 Phase 3c: generated panel artwork, display beside the encoder
    tools/make_panel.py is the single source of the panel layout: it writes
    res/CVSpeak.svg and src/panel_layout.hpp (widget positions), checks for
    overlapping parts and labels, and can render a preview. Two-colour
    artwork (red mask, white silk) with labels in the OLED's pixel font.
    Layout: display on the left with the encoder and Back to its right,
    which freed a knob slot. Intonation moves back to a knob on its original
    param id; the menu keeps Mode and Chirp. Speak sits by the TRIG column.
2026-11-08 Release 2.1.0
    Formant, Bend, Carrier In with Blend, soft-clipped output, the shared
    display and menu (encoder + Back), Intonation knob, and the generated
    panel. Patches from 2.0.x load with their settings.
2026-11-08 Hardware decisions, pin map and Pico 2 firmware skeleton
    hardware/docs: one board, Pico 2 module on headers, ES8388 codec in USB
    mode (12 MHz MCLK from the Pico's crystal on GPOUT0, 48 kHz), Palimpsest's
    power / CV / gate / output blocks, two 74HC4051 muxes, separate 3V3A for
    the analog side, and the GPIO map.
    firmware: Pico SDK 2.3.1 build (make firmware, make firmware-breadboard)
    sharing dsp/ with VCV. ES8388 setup, full-duplex I2S PIO slave, SH1106
    OLED, mux/ADC/encoder controls, UI on core 0, audio on core 1, USB serial
    load meter. Builds; not yet run on hardware.
2026-11-08 Schematic v0.0: scripted KiCad schematic for the dev board
    hardware/scripts/build_sch.py generates CVSpeak.kicad_sch (one A1 sheet):
    power with a 3V3A LDO and VSYS Schottky, Pico 2, ES8388 codec, carrier
    in / audio out (OPA1678), CV and V/OCT stages, gates, EOW, muxes, pots,
    buttons, encoder, OLED, LED and test points. make schematic rebuilds it
    and runs ERC (no errors; the OLED footprint waits on measurements).
    Carrier detect decided: 1M pull-up on the jack's TN lug, read on mux B X5.
    [CVSpeak.kicad_sch]
